TrAyZeN/rp2040-devboard/pcb/rp2040-devboard.kicad_pcb

## KiCad design pcb/rp2040-devboard.kicad_pcb (2024-08-23)

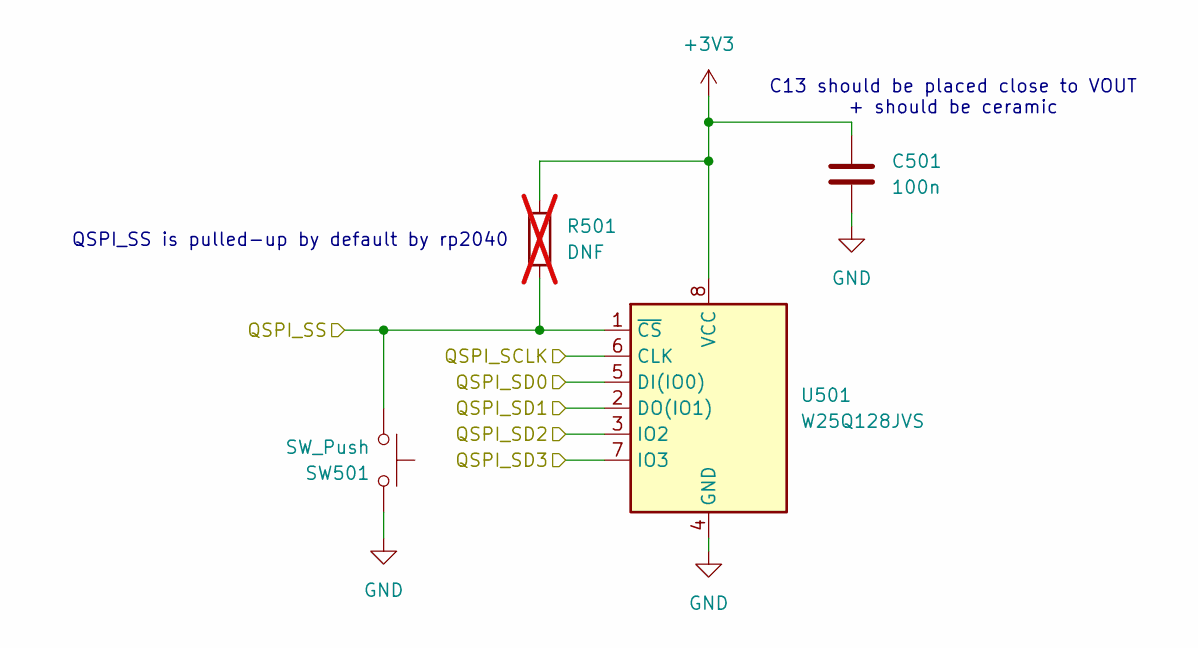
[picture p1: schematic flash.kicad_sch]

Parts:
C501: 100n; C_0603_1608Metric_Pad1.08x0.95mm_HandSolder
R501: DNF; R_0603_1608Metric_Pad0.98x0.95mm_HandSolder; not fitted
SW501: SW_Push; SW_SPST_EVPBV
U501: W25Q128JVS; SOIC-8_5.23x5.23mm_P1.27mm

Connections:
+3V3: C501.1, R501.1, U501.8 (VCC); also elsewhere on the board
/Flash/QSPI_SCLK: U501.6 (CLK); also elsewhere on the board
/Flash/QSPI_SD0: U501.5 (DI(IO0)); also elsewhere on the board
/Flash/QSPI_SD1: U501.2 (DO(IO1)); also elsewhere on the board
/Flash/QSPI_SD2: U501.3 (IO2); also elsewhere on the board
/Flash/QSPI_SD3: U501.7 (IO3); also elsewhere on the board
/Flash/QSPI_SS: R501.2, SW501.1, U501.1 (~CS); also elsewhere on the board
GND: C501.2, SW501.2, U501.4 (GND); also elsewhere on the board

Notes on the sheet:
QSPI_SS is pulled-up by default by rp2040
C13 should be placed close to VOUT + should be ceramic

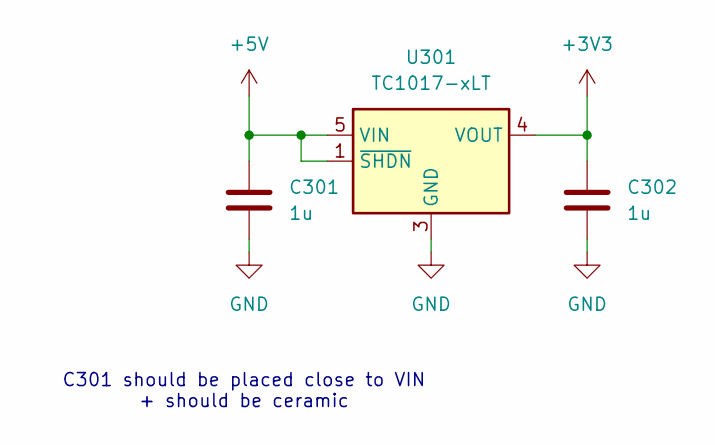
[picture p2: schematic power.kicad_sch]

Parts:
C301, C302: 1u; C_0603_1608Metric_Pad1.08x0.95mm_HandSolder
U301: TC1017-xLT; SOT-353_SC-70-5

Connections:
+3V3: C302.1, U301.4 (VOUT); also elsewhere on the board
+5V: C301.1, U301.1 (~SHDN), U301.5 (VIN); also elsewhere on the board
GND: C301.2, C302.2, U301.3 (GND); also elsewhere on the board

Notes on the sheet:
C301 should be placed close to VIN + should be ceramic

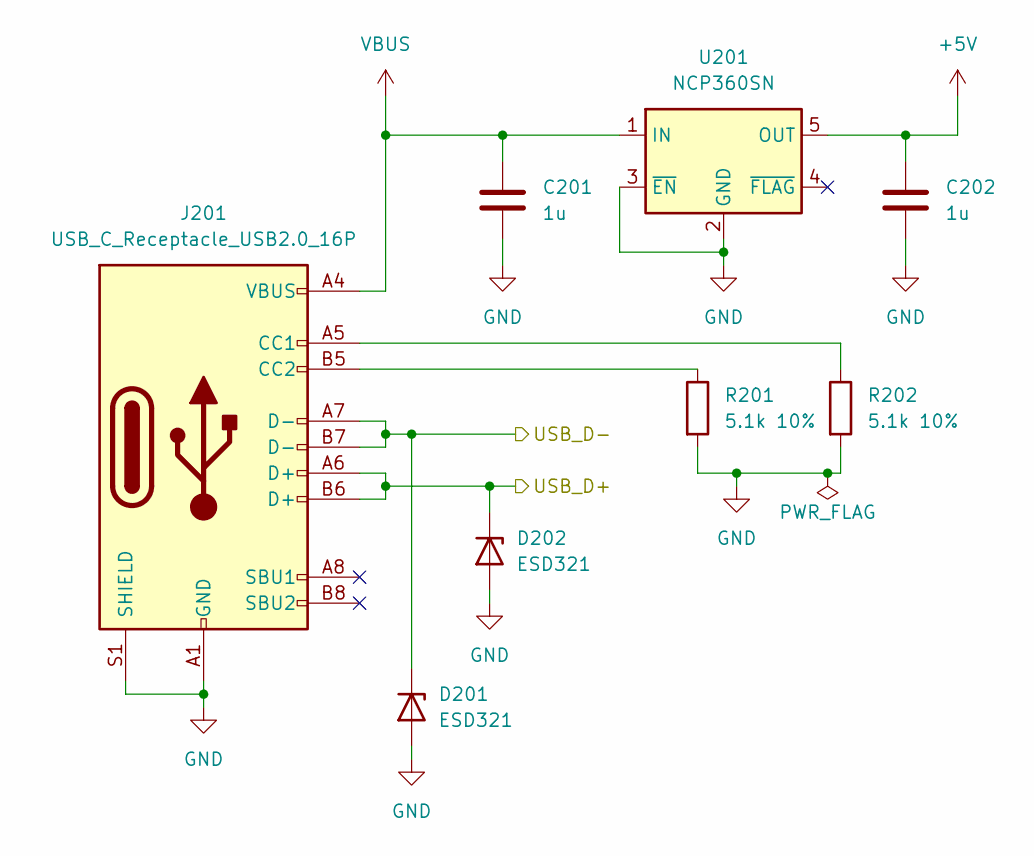
[picture p3: schematic usb.kicad_sch]

Parts:
C201, C202: 1u; C_0603_1608Metric_Pad1.08x0.95mm_HandSolder
D201, D202: ESD321; D_SOD-523
J201: USB_C_Receptacle_USB2.0_16P; USB_C_Receptacle_GCT_USB4105-xx-A_16P_TopMnt_Horizontal
R201, R202: 5.1k 10%; R_0603_1608Metric_Pad0.98x0.95mm_HandSolder
U201: NCP360SN; TSOP-5_1.65x3.05mm_P0.95mm

Connections:
+5V: C202.1, U201.5 (OUT); also elsewhere on the board
/USB/USB_D+: D202.1 (K), J201.A6 (D+), J201.B6 (D+); also elsewhere on the board
/USB/USB_D-: D201.1 (K), J201.A7 (D-), J201.B7 (D-); also elsewhere on the board
GND: C201.2, C202.2, D201.2 (A), D202.2 (A), J201.A1 (GND), J201.A12 (GND), J201.B1 (GND), J201.B12 (GND), J201.S1 (SHIELD), R201.2, R202.2, U201.2 (GND), U201.3 (~EN); also elsewhere on the board
unnamed: J201.A5 (CC1), R202.1
unnamed: J201.B5 (CC2), R201.1
VBUS: C201.1, J201.A4 (VBUS), J201.A9 (VBUS), J201.B4 (VBUS), J201.B9 (VBUS), U201.1 (IN)

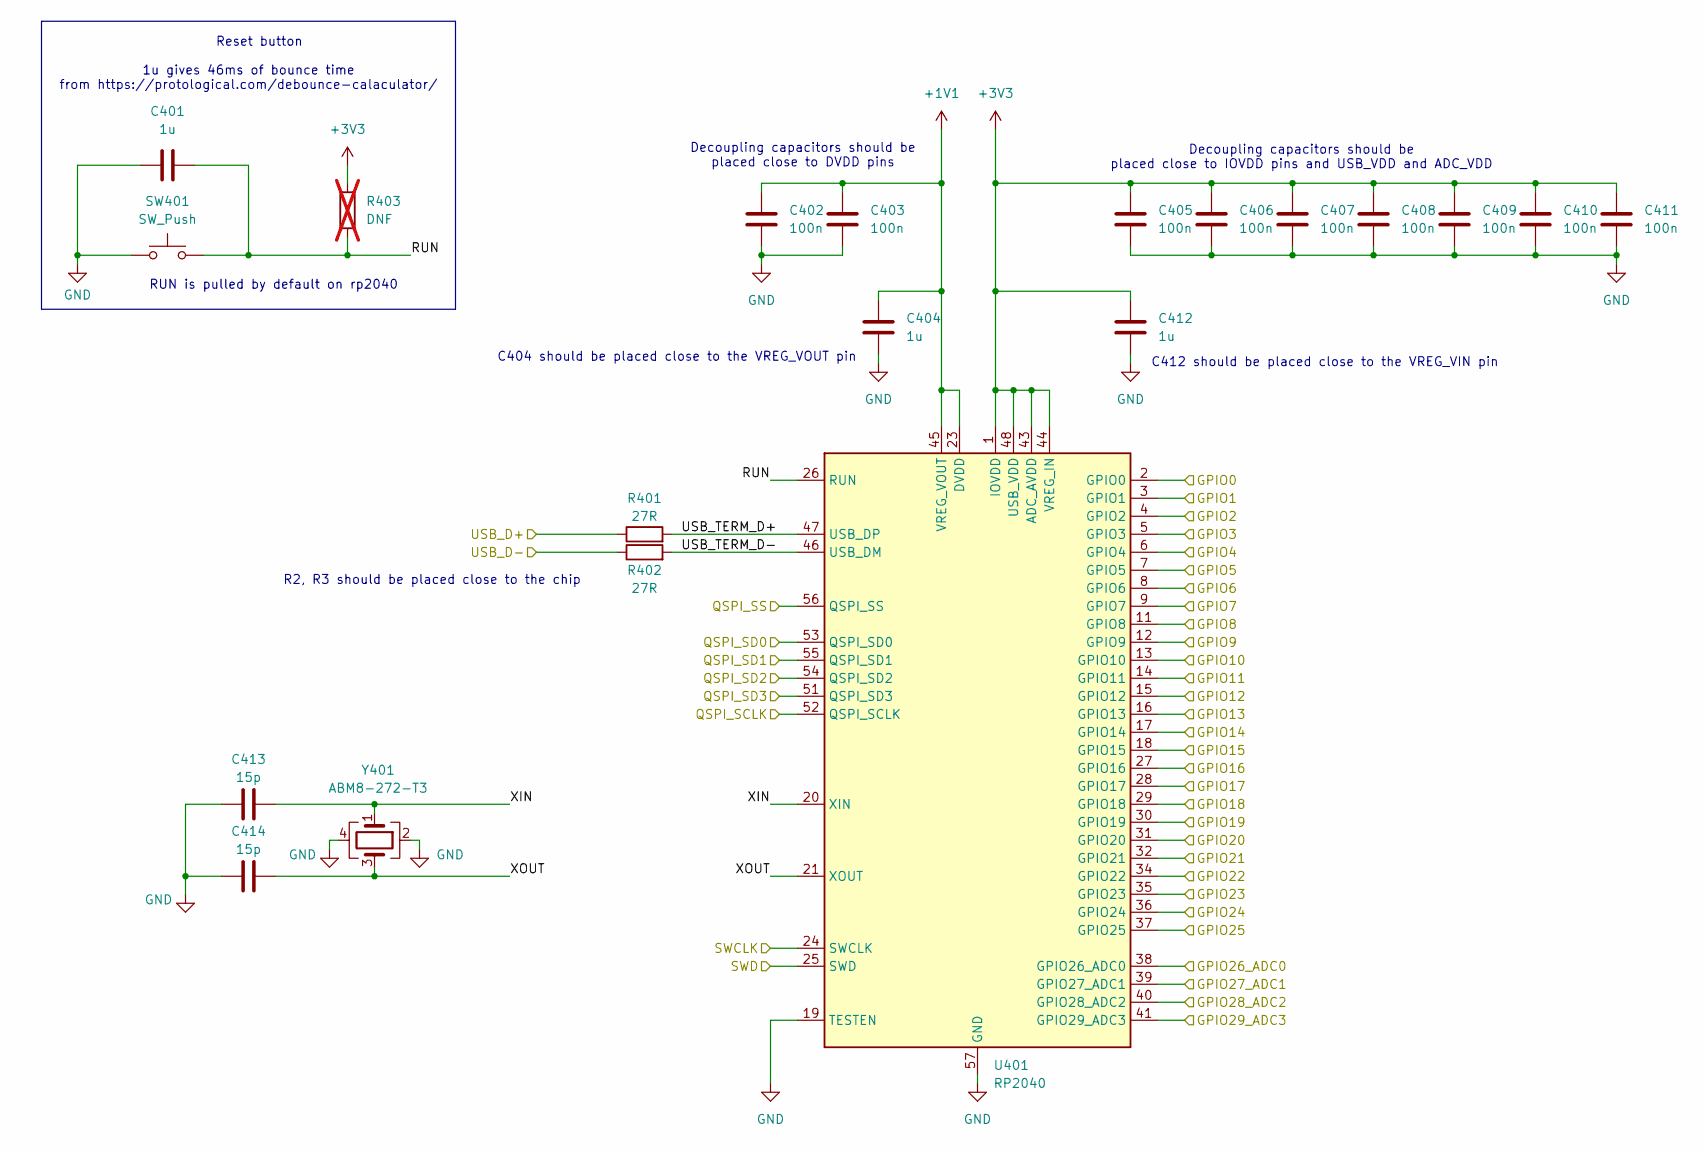
[picture p4: schematic rp2040.kicad_sch]

Parts:
C401, C404, C412: 1u; C_0603_1608Metric_Pad1.08x0.95mm_HandSolder
C402, C403, C405, C406, C407, C408, C409, C410, C411: 100n; C_0603_1608Metric_Pad1.08x0.95mm_HandSolder
C413, C414: 15p; C_0603_1608Metric_Pad1.08x0.95mm_HandSolder
R401, R402: 27R; R_0603_1608Metric_Pad0.98x0.95mm_HandSolder
R403: DNF; R_0603_1608Metric_Pad0.98x0.95mm_HandSolder; not fitted
SW401: SW_Push; SW_SPST_EVPBV
U401: RP2040; QFN-56-1EP_7x7mm_P0.4mm_EP3.2x3.2mm
Y401: ABM8-272-T3; Crystal_SMD_3225-4Pin_3.2x2.5mm

Connections:
+1V1: C402.1, C403.1, C404.1, U401.23 (DVDD), U401.45 (VREG_VOUT), U401.50 (DVDD)
+3V3: C405.1, C406.1, C407.1, C408.1, C409.1, C410.1, C411.1, C412.1, R403.1, U401.1 (IOVDD), U401.10 (IOVDD), U401.22 (IOVDD), U401.33 (IOVDD), U401.42 (IOVDD), U401.43 (ADC_AVDD), U401.44 (VREG_IN), U401.48 (USB_VDD), U401.49 (IOVDD); also elsewhere on the board
/Flash/QSPI_SCLK: U401.52 (QSPI_SCLK); also elsewhere on the board
/Flash/QSPI_SD0: U401.53 (QSPI_SD0); also elsewhere on the board
/Flash/QSPI_SD1: U401.55 (QSPI_SD1); also elsewhere on the board
/Flash/QSPI_SD2: U401.54 (QSPI_SD2); also elsewhere on the board
/Flash/QSPI_SD3: U401.51 (QSPI_SD3); also elsewhere on the board
/Flash/QSPI_SS: U401.56 (QSPI_SS); also elsewhere on the board
/IO/GPIO0: U401.2 (GPIO0); also elsewhere on the board
/IO/GPIO1: U401.3 (GPIO1); also elsewhere on the board
/IO/GPIO2: U401.4 (GPIO2); also elsewhere on the board
/IO/GPIO3: U401.5 (GPIO3); also elsewhere on the board
/IO/GPIO4: U401.6 (GPIO4); also elsewhere on the board
/IO/GPIO5: U401.7 (GPIO5); also elsewhere on the board
/IO/GPIO6: U401.8 (GPIO6); also elsewhere on the board
/IO/GPIO7: U401.9 (GPIO7); also elsewhere on the board
/IO/GPIO8: U401.11 (GPIO8); also elsewhere on the board
/IO/GPIO9: U401.12 (GPIO9); also elsewhere on the board
/IO/GPIO10: U401.13 (GPIO10); also elsewhere on the board
/IO/GPIO11: U401.14 (GPIO11); also elsewhere on the board
/IO/GPIO12: U401.15 (GPIO12); also elsewhere on the board
/IO/GPIO13: U401.16 (GPIO13); also elsewhere on the board
/IO/GPIO14: U401.17 (GPIO14); also elsewhere on the board
/IO/GPIO15: U401.18 (GPIO15); also elsewhere on the board
/IO/GPIO16: U401.27 (GPIO16); also elsewhere on the board
/IO/GPIO17: U401.28 (GPIO17); also elsewhere on the board
/IO/GPIO18: U401.29 (GPIO18); also elsewhere on the board
/IO/GPIO19: U401.30 (GPIO19); also elsewhere on the board
/IO/GPIO20: U401.31 (GPIO20); also elsewhere on the board
/IO/GPIO21: U401.32 (GPIO21); also elsewhere on the board
/IO/GPIO22: U401.34 (GPIO22); also elsewhere on the board
/IO/GPIO23: U401.35 (GPIO23); also elsewhere on the board
/IO/GPIO24: U401.36 (GPIO24); also elsewhere on the board
/IO/GPIO25: U401.37 (GPIO25); also elsewhere on the board
/IO/GPIO26_ADC0: U401.38 (GPIO26_ADC0); also elsewhere on the board
/IO/GPIO27_ADC1: U401.39 (GPIO27_ADC1); also elsewhere on the board
/IO/GPIO28_ADC2: U401.40 (GPIO28_ADC2); also elsewhere on the board
/IO/GPIO29_ADC3: U401.41 (GPIO29_ADC3); also elsewhere on the board
/IO/SWCLK: U401.24 (SWCLK); also elsewhere on the board
/IO/SWD: U401.25 (SWD); also elsewhere on the board
/USB/USB_D+: R401.1; also elsewhere on the board
/USB/USB_D-: R402.1; also elsewhere on the board
/rp2040/RUN: C401.2, R403.2, SW401.2, U401.26 (RUN)
/rp2040/USB_TERM_D+: R401.2, U401.47 (USB_DP)
/rp2040/USB_TERM_D-: R402.2, U401.46 (USB_DM)
/rp2040/XIN: C413.2, U401.20 (XIN), Y401.1
/rp2040/XOUT: C414.2, U401.21 (XOUT), Y401.3
GND: C401.1, C402.2, C403.2, C404.2, C405.2, C406.2, C407.2, C408.2, C409.2, C410.2, C411.2, C412.2, C413.1, C414.1, SW401.1, U401.19 (TESTEN), U401.57 (GND), Y401.2, Y401.4; also elsewhere on the board

Notes on the sheet:
C412 should be placed close to the VREG_VIN pin
Decoupling capacitors should be placed close to DVDD pins
Reset button
RUN is pulled by default on rp2040
R2, R3 should be placed close to the chip
Decoupling capacitors should be placed close to IOVDD pins and USB_VDD and ADC_VDD
1u gives 46ms of bounce time from https://protological.com/debounce-calaculator/
C404 should be placed close to the VREG_VOUT pin

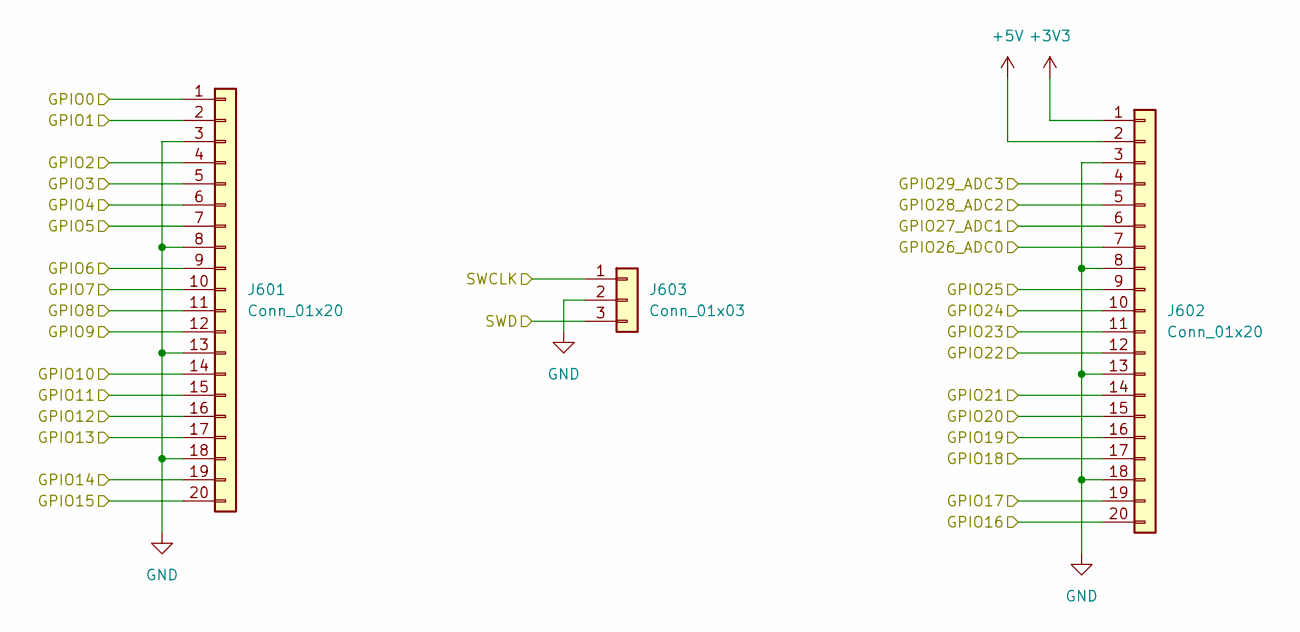
[picture p5: schematic io.kicad_sch]

Parts:
J601, J602: Conn_01x20; PinHeader_1x20_P2.54mm_Vertical
J603: Conn_01x03; PinHeader_1x03_P2.54mm_Vertical

Connections:
+3V3: J602.1; also elsewhere on the board
+5V: J602.2; also elsewhere on the board
/IO/GPIO0: J601.1; also elsewhere on the board
/IO/GPIO1: J601.2; also elsewhere on the board
/IO/GPIO2: J601.4; also elsewhere on the board
/IO/GPIO3: J601.5; also elsewhere on the board
/IO/GPIO4: J601.6; also elsewhere on the board
/IO/GPIO5: J601.7; also elsewhere on the board
/IO/GPIO6: J601.9; also elsewhere on the board
/IO/GPIO7: J601.10; also elsewhere on the board
/IO/GPIO8: J601.11; also elsewhere on the board
/IO/GPIO9: J601.12; also elsewhere on the board
/IO/GPIO10: J601.14; also elsewhere on the board
/IO/GPIO11: J601.15; also elsewhere on the board
/IO/GPIO12: J601.16; also elsewhere on the board
/IO/GPIO13: J601.17; also elsewhere on the board
/IO/GPIO14: J601.19; also elsewhere on the board
/IO/GPIO15: J601.20; also elsewhere on the board
/IO/GPIO16: J602.20; also elsewhere on the board
/IO/GPIO17: J602.19; also elsewhere on the board
/IO/GPIO18: J602.17; also elsewhere on the board
/IO/GPIO19: J602.16; also elsewhere on the board
/IO/GPIO20: J602.15; also elsewhere on the board
/IO/GPIO21: J602.14; also elsewhere on the board
/IO/GPIO22: J602.12; also elsewhere on the board
/IO/GPIO23: J602.11; also elsewhere on the board
/IO/GPIO24: J602.10; also elsewhere on the board
/IO/GPIO25: J602.9; also elsewhere on the board
/IO/GPIO26_ADC0: J602.7; also elsewhere on the board
/IO/GPIO27_ADC1: J602.6; also elsewhere on the board
/IO/GPIO28_ADC2: J602.5; also elsewhere on the board
/IO/GPIO29_ADC3: J602.4; also elsewhere on the board
/IO/SWCLK: J603.1; also elsewhere on the board
/IO/SWD: J603.3; also elsewhere on the board
GND: J601.3, J601.8, J601.13, J601.18, J602.3, J602.8, J602.13, J602.18, J603.2; also elsewhere on the board

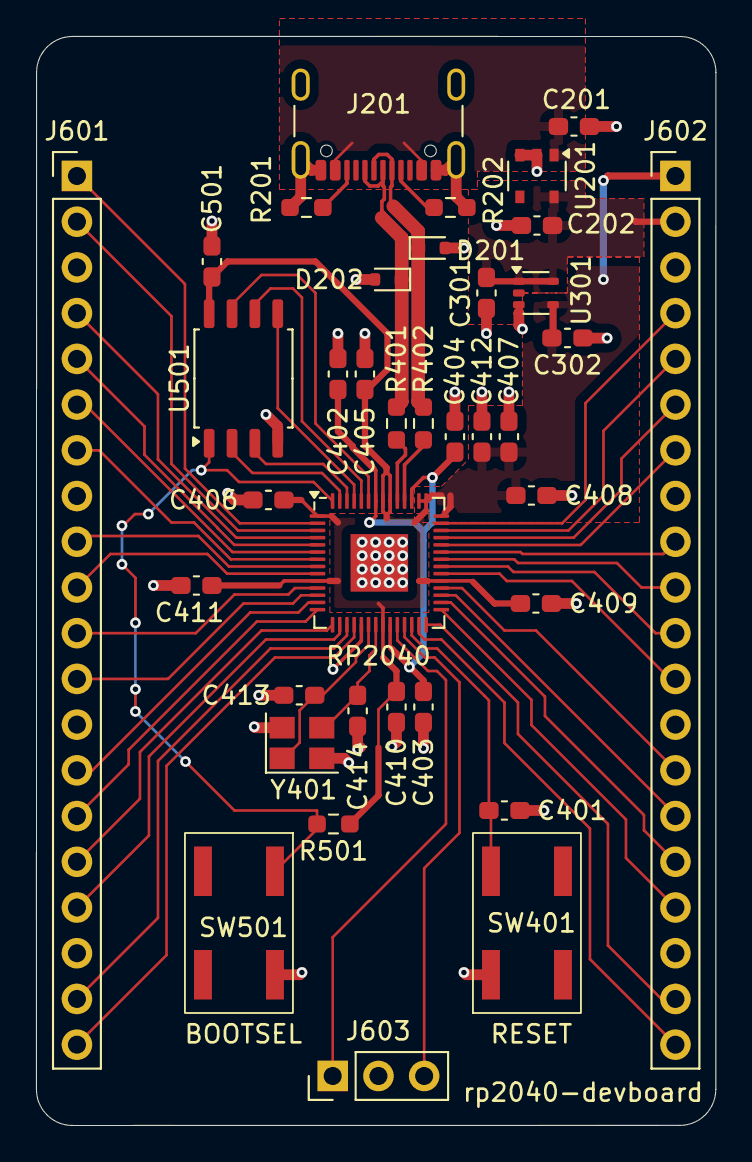
[picture p6: board rp2040-devboard.kicad_pcb from above]

Board: 2 copper layers, 37.8 x 60.5 mm, 37 parts (0 on the bottom side), 52 nets.
