TrAyZeN/rp2040-devboard/(commit log)

2024-05-27 add schematic
    [flash.kicad_sch, io.kicad_sch, power.kicad_sch, rp2040-devboard.kicad_pcb, rp2040-devboard.kicad_sch, rp2040.kicad_sch, usb.kicad_sch]
2024-05-28 add footprints
    [flash.kicad_sch, power.kicad_sch, rp2040.kicad_sch, usb.kicad_sch]
2024-06-09 add footprints + expose grounds and power on pins
    [io.kicad_sch, rp2040.kicad_sch, usb.kicad_sch]
2024-06-09 wip pcb placement
    [rp2040-devboard.kicad_pcb]
2024-06-23 change footprint
    [flash.kicad_sch, power.kicad_sch, rp2040-devboard.kicad_pcb, rp2040.kicad_sch, usb.kicad_sch]
2024-07-13 finish routing
    [rp2040-devboard.kicad_pcb, rp2040-devboard.kicad_sch, rp2040.kicad_sch, usb.kicad_sch]
2024-08-13 mirror back silkscreen
    [rp2040-devboard.kicad_pcb]
2024-08-23 add debouncing capacitor value and dnp pull up
    [flash.kicad_sch, rp2040-devboard.kicad_pcb, rp2040.kicad_sch]
2024-08-23 add interactive bom config
